PV-Lab/vcd/README.md

# vcd
A vacuum crystallization drying build within the ADDEPT collaboration
