PV-Lab/vcd/stp files/10cm VCD perforated sample stage.stp

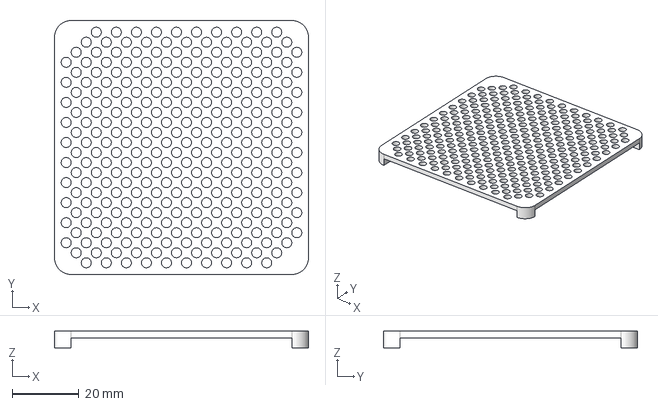
[picture p1: CAD file, 2026-03-06]
stp files/10cm VCD perforated sample stage.stp
76.0 x 76.0 x 5.00 mm
