PV-Lab/vcd/stp files/10cm VCD lid with window.stp

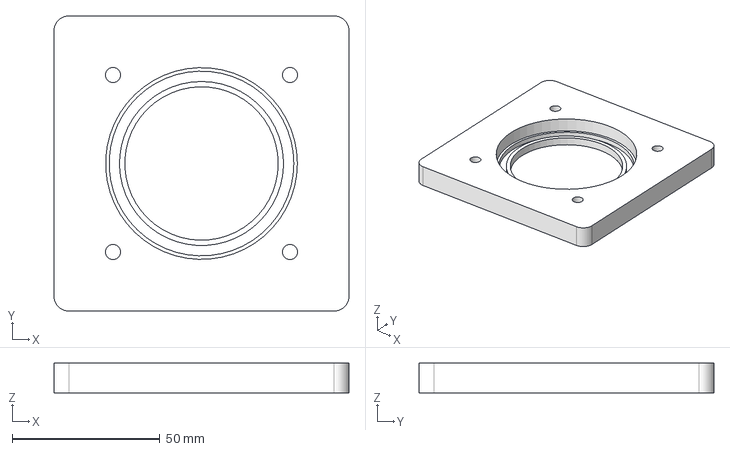
[picture p2: CAD file, 2026-03-06]
stp files/10cm VCD lid with window.stp
100.0 x 100.0 x 10.0 mm
