PV-Lab/vcd/stp files/10cm VCD GIWAXS sample stage.stp

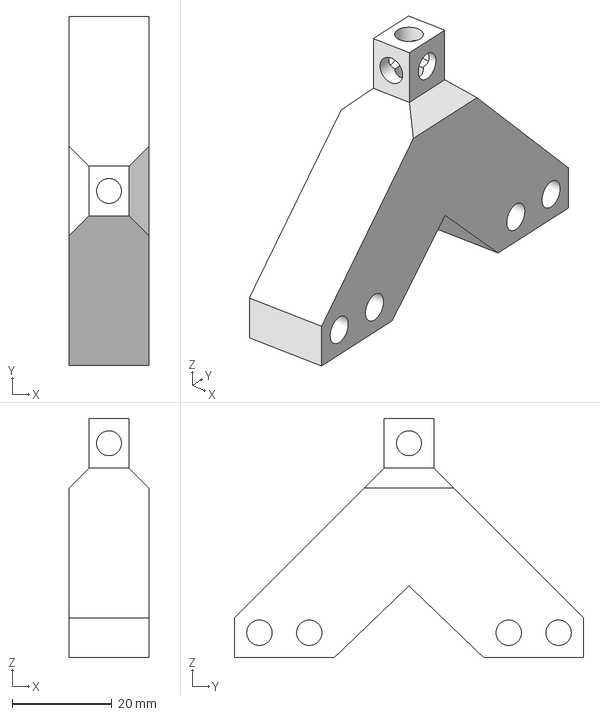
[picture p3: CAD file, 2026-03-06]
stp files/10cm VCD GIWAXS sample stage.stp
16.0 x 70.0 x 48.0 mm
