PV-Lab/vcd/stp files/10cm VCD GIWAXS lid.stp

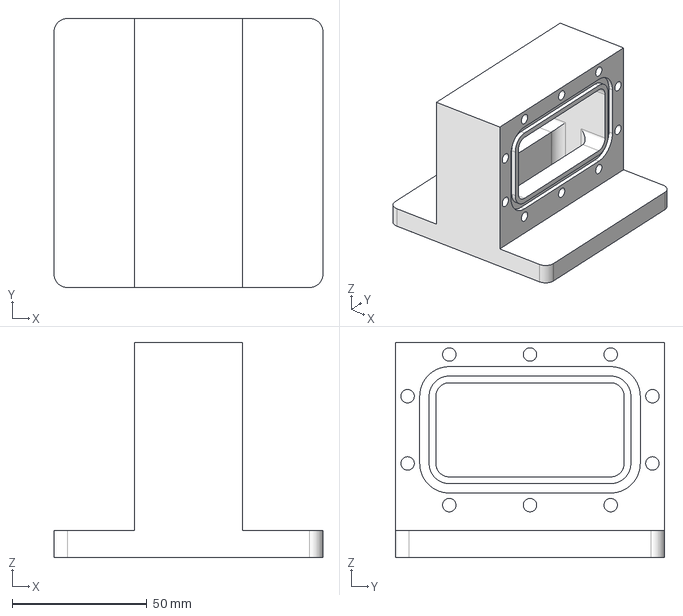
[picture p4: CAD file, 2026-03-06]
stp files/10cm VCD GIWAXS lid.stp
100.0 x 100.0 x 80.0 mm
