PV-Lab/vcd/stp files/10cm VCD base chamber.stp

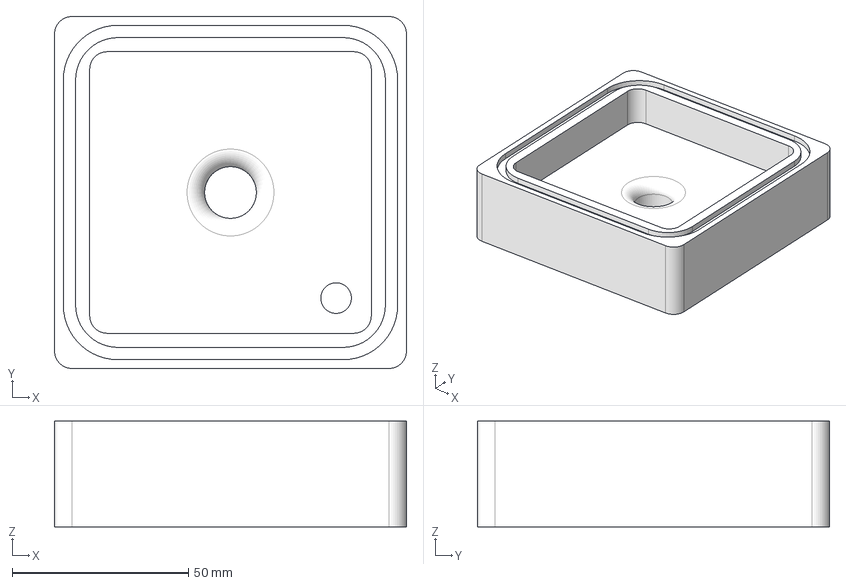
[picture p5: CAD file, 2026-03-06]
stp files/10cm VCD base chamber.stp
100.0 x 100.0 x 30.0 mm
