PV-Lab/vcd/stp files/10cm VCD GIWAXS window holders.stp

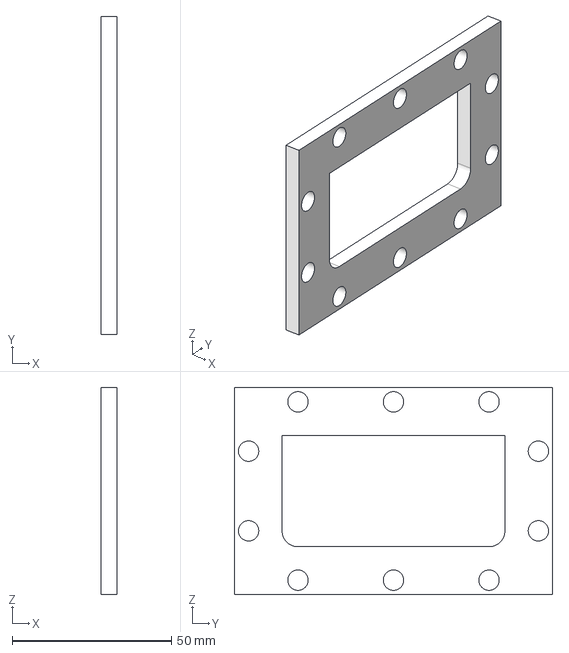
[picture p6: CAD file, 2026-03-06]
stp files/10cm VCD GIWAXS window holders.stp
5.00 x 100.0 x 65.0 mm
