PV-Lab/vcd/stp files/10cm VCD window mounting plate.stp

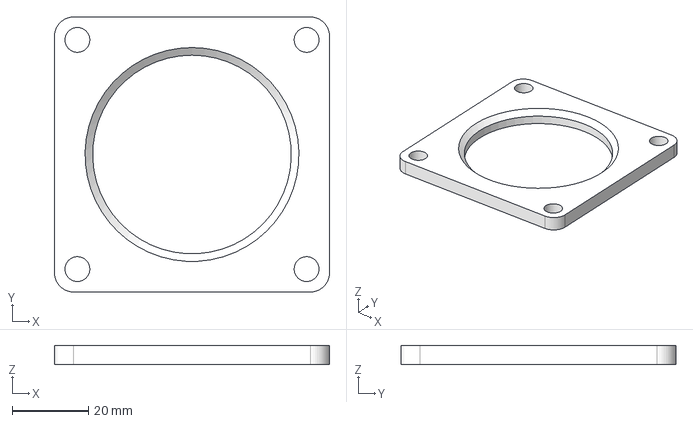
[picture p7: CAD file, 2026-03-06]
stp files/10cm VCD window mounting plate.stp
72.0 x 72.0 x 5.00 mm
