PV-Lab/vcd/stp files/10cm VCD base chamber side and bottom NPT.stp

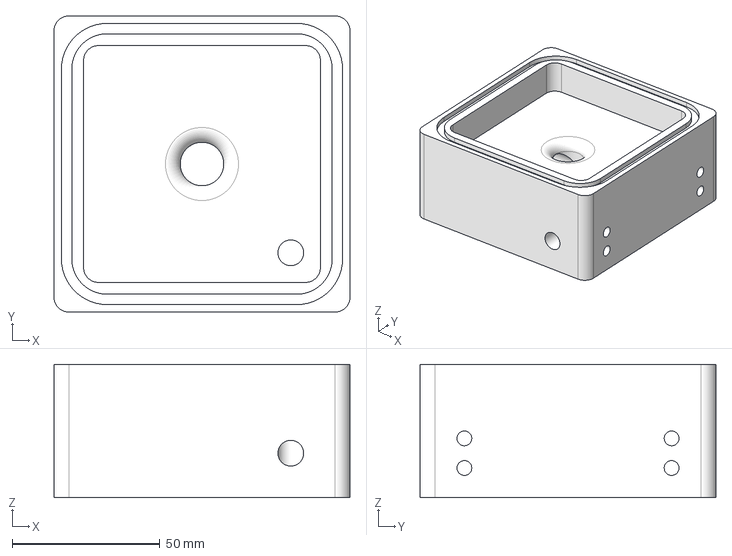
[picture p8: CAD file, 2026-03-06]
stp files/10cm VCD base chamber side and bottom NPT.stp
100.0 x 100.0 x 45.0 mm
