PV-Lab/vcd/solidworks/B-2MA4-SwagelokCompany-3D-07-16-2025.SLDPRT

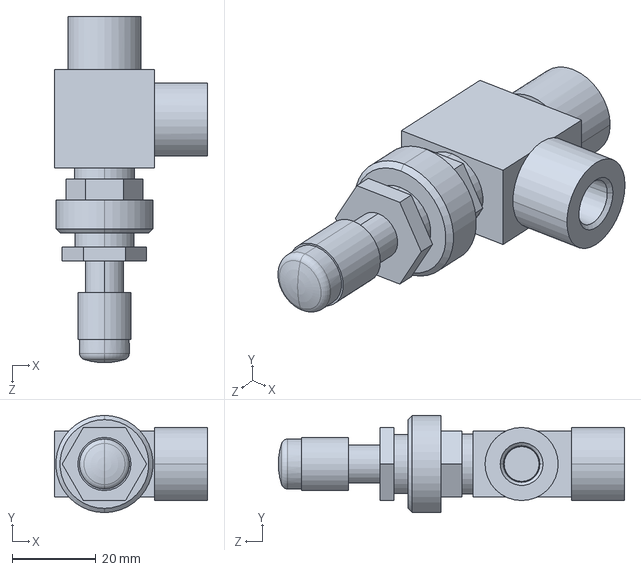
[picture p9: CAD file, 2026-04-05]
solidworks/B-2MA4-SwagelokCompany-3D-07-16-2025.SLDPRT
36.6 x 23.2 x 82.8 mm
