PV-Lab/vcd/solidworks/D1G1011200-A-APG200-XM-NW16-9-PIND.SLDPRT

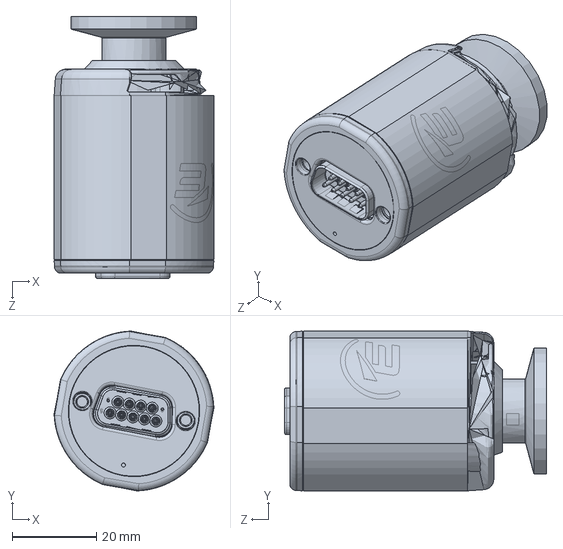
[picture p10: CAD file, 2026-04-05]
solidworks/D1G1011200-A-APG200-XM-NW16-9-PIND.SLDPRT
38.0 x 38.0 x 62.3 mm
