PV-Lab/vcd/solidworks/Window O-Ring.SLDPRT

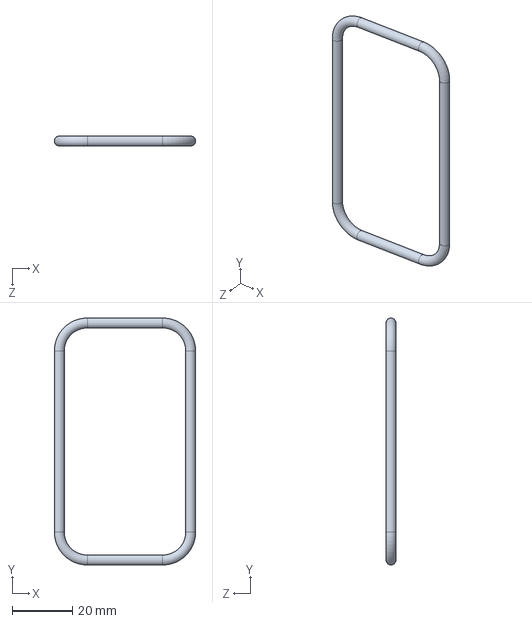
[picture p11: CAD file, 2026-04-05]
solidworks/Window O-Ring.SLDPRT
46.8 x 81.8 x 3.30 mm
