PV-Lab/vcd/solidworks/Lid O-Ring.SLDPRT

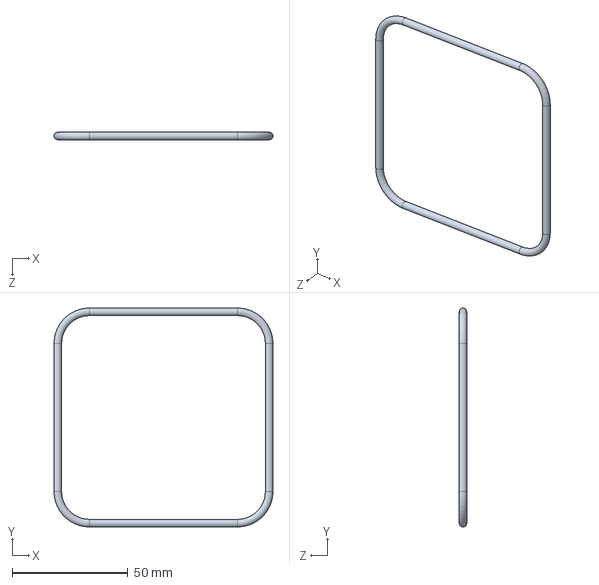
[picture p12: CAD file, 2026-04-05]
solidworks/Lid O-Ring.SLDPRT
94.8 x 94.8 x 3.30 mm
