PV-Lab/vcd/solidworks/Lid Window Film.SLDPRT

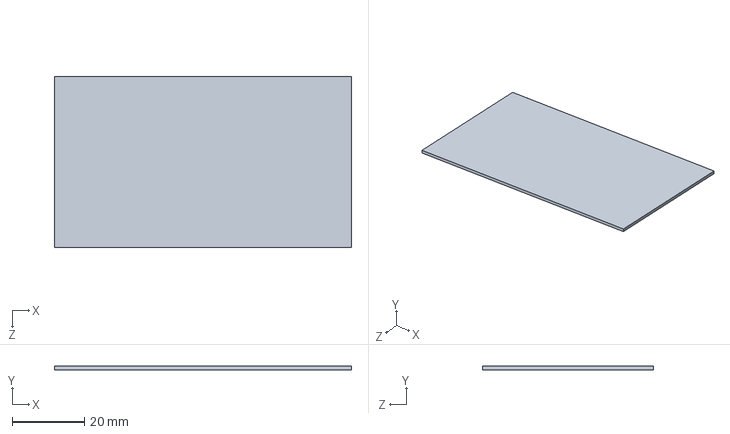
[picture p13: CAD file, 2026-04-05]
solidworks/Lid Window Film.SLDPRT
82.5 x 1.00 x 47.5 mm
