PV-Lab/vcd/solidworks/48805K72_Precision Extreme-Pressure 316 Stainless Steel Fitting.SLDPRT

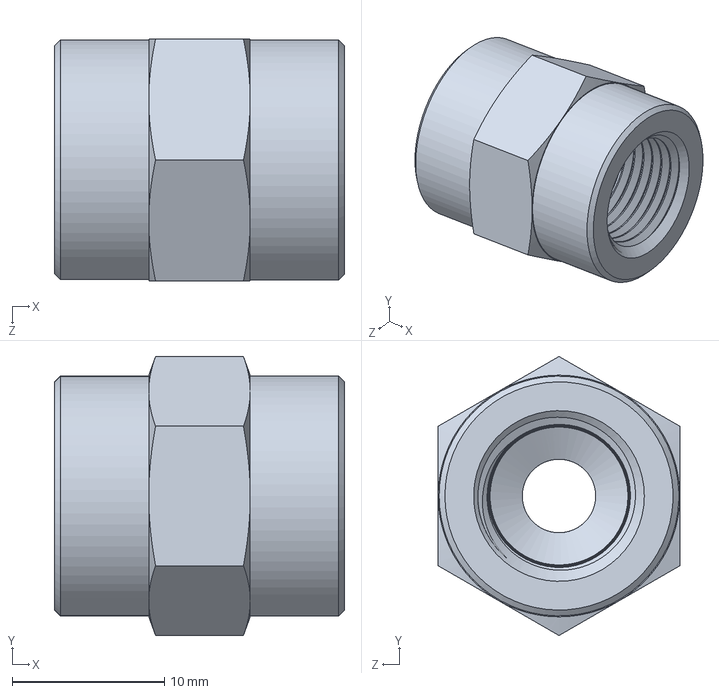
[picture p14: CAD file, 2026-04-05]
solidworks/48805K72_Precision Extreme-Pressure 316 Stainless Steel Fitting.SLDPRT
19.1 x 18.3 x 15.9 mm
