PV-Lab/vcd/solidworks/9263K521_Chemical-Resistant Viton Fluoroelastomer O-Ring.SLDPRT

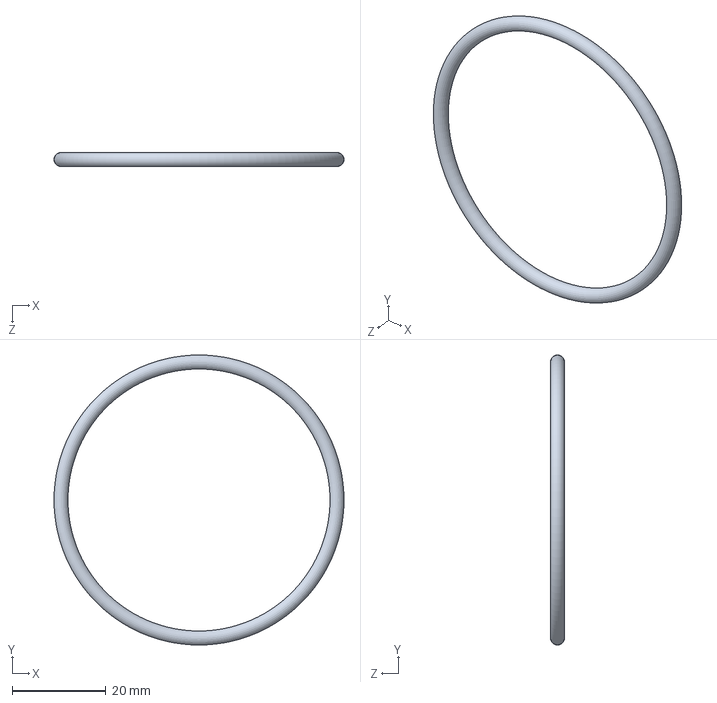
[picture p15: CAD file, 2026-04-05]
solidworks/9263K521_Chemical-Resistant Viton Fluoroelastomer O-Ring.SLDPRT
62.0 x 62.0 x 3.00 mm
