PV-Lab/vcd/solidworks/VCDwithwindow_exploded.SLDASM

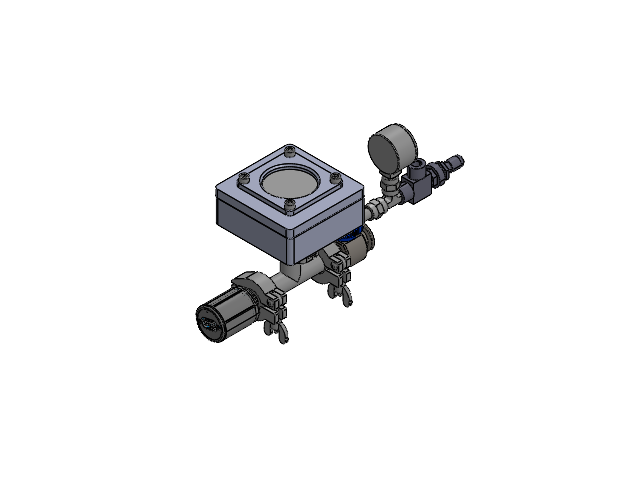
[picture p16: CAD file, 2026-04-05]
solidworks/VCDwithwindow_exploded.SLDASM
4518K191_Quick-Clamp High-Vacuum Fitting
4518K815_Ring with Screen for 3-4 Tube OD Quick-Clamp High-Vacuum Fitting
10cm VCD base chamber
Lid O-Ring
4518K621_Fluoroelastomer Rubber O-Ring for 3-4 Tube OD Quick-Clamp High-Vacuum Fitting x 2
48805K18_Precision Extreme-Pressure 316 Stainless Steel Fitting
4002K15_Vacuum Gauge with Steel Case
44615K421_Standard-Wall Steel Pipe Nipple
48805K124_Precision Extreme-Pressure 316 Stainless Steel Fitting
48805K72_Precision Extreme-Pressure 316 Stainless Steel Fitting x 2
B-2MA4-SwagelokCompany-3D-07-16-2025
4518K711_Quick-Clamp High-Vacuum Fitting x 3
P104242
10cm VCD lid with window
10cm VCD perforated sample stage
10cm VCD window mounting plate
1357T55_Ultra-High-Temperature Quartz Glass
9263K521_Chemical-Resistant Viton Fluoroelastomer O-Ring x 2
D1G1011200-A-APG200-XM-NW16-9-PIND
92290A316_Super-Corrosion-Resistant 316 Stainless Steel Socket Head Screw x 4
P108308
