PV-Lab/vcd/solidworks/VCDgiwaxs_exploded.SLDASM

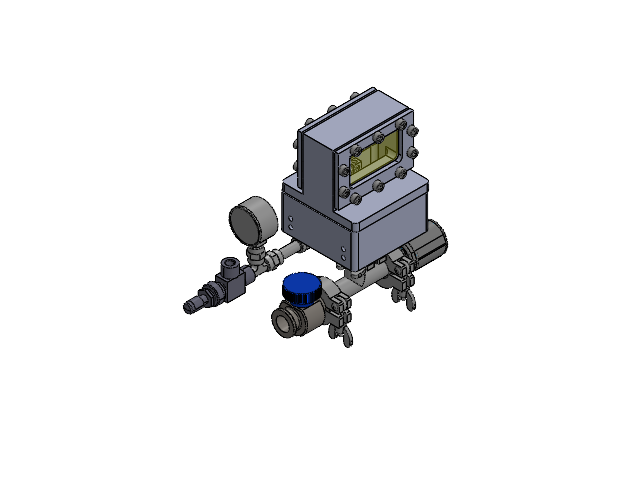
[picture p17: CAD file, 2026-04-05]
solidworks/VCDgiwaxs_exploded.SLDASM
4518K191_Quick-Clamp High-Vacuum Fitting
4518K815_Ring with Screen for 3-4 Tube OD Quick-Clamp High-Vacuum Fitting
Lid O-Ring
4518K621_Fluoroelastomer Rubber O-Ring for 3-4 Tube OD Quick-Clamp High-Vacuum Fitting x 2
48805K18_Precision Extreme-Pressure 316 Stainless Steel Fitting
4002K15_Vacuum Gauge with Steel Case
44615K421_Standard-Wall Steel Pipe Nipple
48805K124_Precision Extreme-Pressure 316 Stainless Steel Fitting
48805K72_Precision Extreme-Pressure 316 Stainless Steel Fitting x 2
B-2MA4-SwagelokCompany-3D-07-16-2025
4518K711_Quick-Clamp High-Vacuum Fitting x 3
P104242
D1G1011200-A-APG200-XM-NW16-9-PIND
10cm VCD base chamber side and bottom NPT
10cm VCD GIWAXS lid
10cm VCD GIWAXS sample stage
10cm VCD GIWAXS window holders x 2
91290A207_Black-Oxide Alloy Steel Socket Head Screw x 4
Window O-Ring x 2
Lid Window Film x 2
50925K389_Compact Extreme-Pressure Steel Pipe Fitting
50925K392_Compact Extreme-Pressure Steel Pipe Fitting
92290A316_Super-Corrosion-Resistant 316 Stainless Steel Socket Head Screw x 20
P108308
