PV-Lab/vcd/(list of files, cad)

Other CAD files:
solidworks/10cm VCD GIWAXS lid.SLDPRT
solidworks/10cm VCD GIWAXS sample stage.SLDPRT
solidworks/10cm VCD GIWAXS window holders.SLDPRT
solidworks/10cm VCD base chamber side and bottom NPT.SLDPRT
solidworks/10cm VCD base chamber.SLDPRT
solidworks/10cm VCD lid no window.SLDPRT
solidworks/10cm VCD lid with window.SLDPRT
solidworks/10cm VCD perforated sample stage.SLDPRT
solidworks/10cm VCD window mounting plate.SLDPRT
solidworks/1357T55_Ultra-High-Temperature Quartz Glass.SLDPRT
solidworks/4002K15_Vacuum Gauge with Steel Case.SLDPRT
solidworks/44615K421_Standard-Wall Steel Pipe Nipple.SLDPRT
solidworks/4518K191_Quick-Clamp High-Vacuum Fitting.SLDPRT
solidworks/4518K621_Fluoroelastomer Rubber O-Ring for 3-4 Tube OD Quick-Clamp High-Vacuum Fitting.SLDPRT
solidworks/4518K711_Quick-Clamp High-Vacuum Fitting.SLDPRT
solidworks/4518K815_Ring with Screen for 3-4 Tube OD Quick-Clamp High-Vacuum Fitting.SLDPRT
solidworks/48805K124_Precision Extreme-Pressure 316 Stainless Steel Fitting.SLDPRT
solidworks/48805K18_Precision Extreme-Pressure 316 Stainless Steel Fitting.SLDPRT
solidworks/50925K389_Compact Extreme-Pressure Steel Pipe Fitting.SLDPRT
solidworks/50925K392_Compact Extreme-Pressure Steel Pipe Fitting.SLDPRT
solidworks/7784N47_Ultra-High-Temperature Quartz Glass Sheet.SLDPRT
solidworks/91290A207_Black-Oxide Alloy Steel Socket Head Screw.SLDPRT
solidworks/92290A316_Super-Corrosion-Resistant 316 Stainless Steel Socket Head Screw.SLDPRT
solidworks/P101217.sldprt
solidworks/P104242.sldprt
solidworks/P108308.sldprt
