PV-Lab/vcd/Dimensioned Drawings/10cm VCD lid with window.pdf

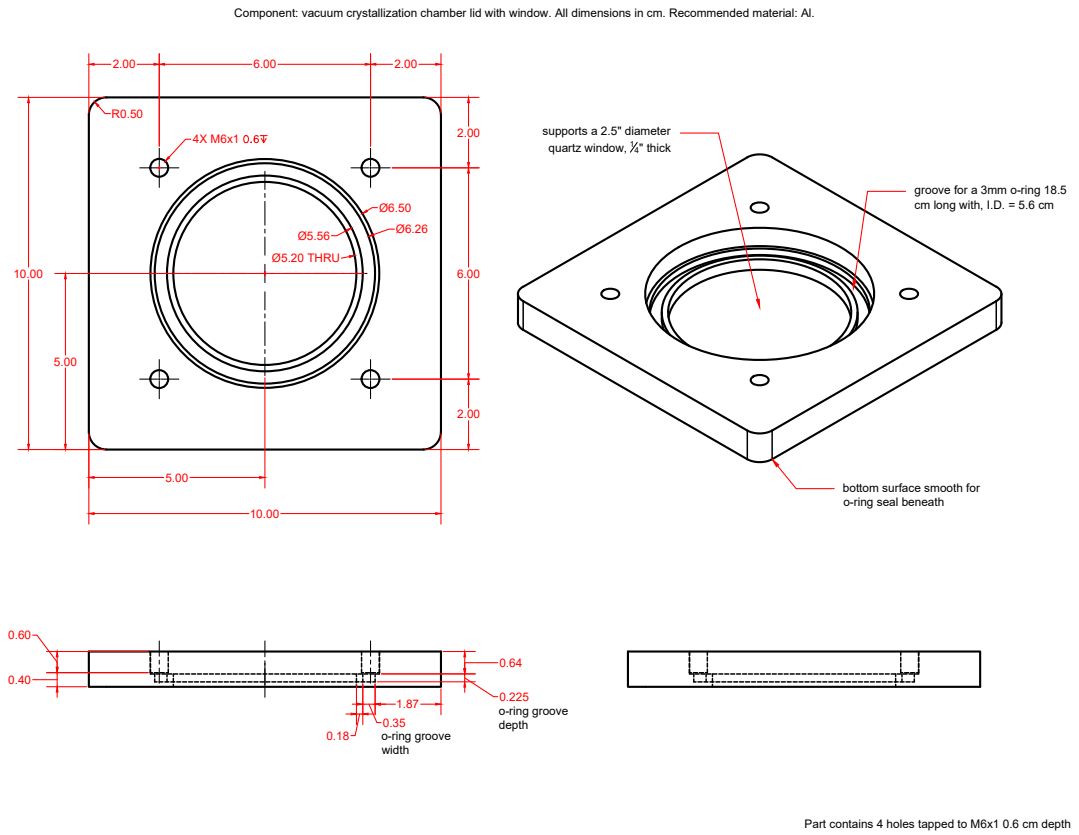
[picture p18: page 1]
Component: vacuum crystallization chamber lid with window. All dimensions in cm. Recommended material: Al. 10.00; 2.00 6.00 2.00 Ø5.20 THRU Ø5.56; 0.64 0.225 o-ring groove depth 0.40; o-ring groove width R0.50; bottom surface smooth for o-ring seal beneath groove for a 3mm o-ring 18.5 cm long with, I.D. = 5.6 cm supports a 2.5" diameter quartz window, 1; 4" thick; Part contains 4 holes tapped to M6x1 0.6 cm depth
