PV-Lab/vcd/Dimensioned Drawings/10cm VCD window mounting plate.pdf

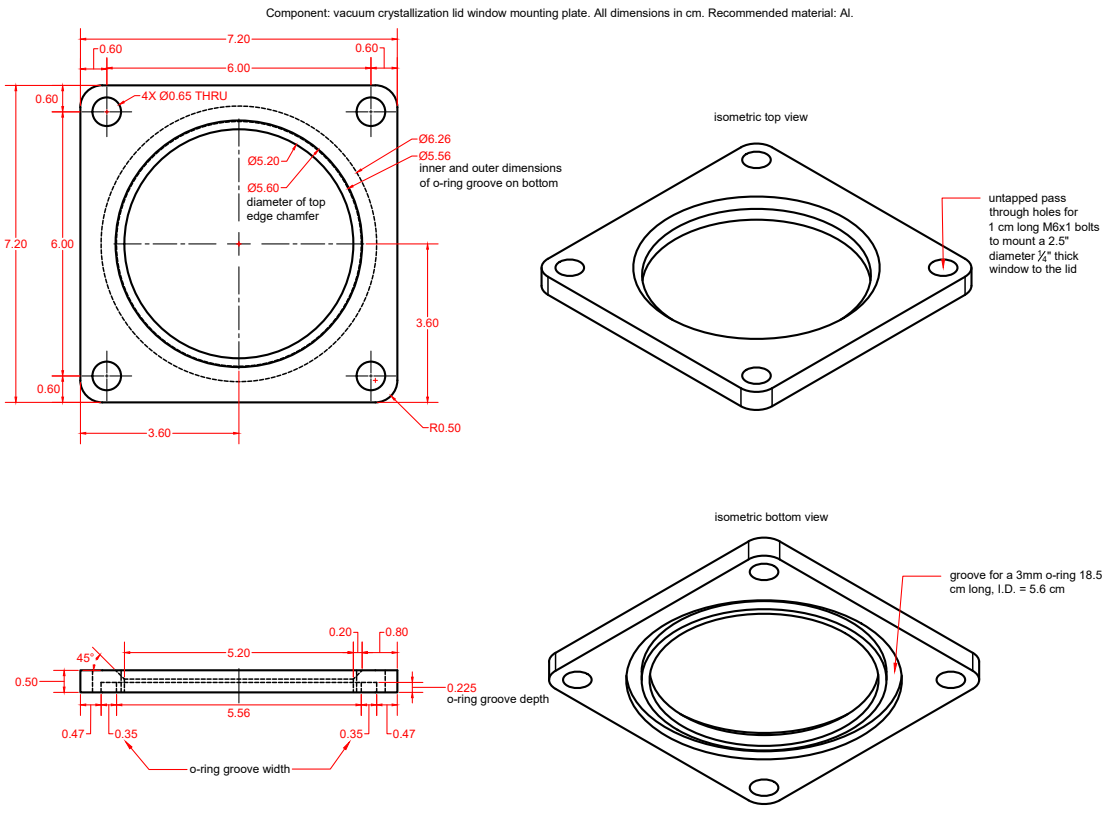
[picture p19: page 1]
Component: vacuum crystallization lid window mounting plate. All dimensions in cm. Recommended material: Al. isometric top view isometric bottom view 4X Ø0.65 THRU 7.20; Ø6.26 Ø5.56 inner and outer dimensions of o-ring groove on bottom Ø5.20 Ø5.60 3.60; untapped pass through holes for 1 cm long M6x1 bolts to mount a 2.5" diameter 1; 4" thick window to the lid groove for a 3mm o-ring 18.5 cm long, I.D. = 5.6 cm 0.47; 0.225 o-ring groove depth o-ring groove width 0.50; diameter of top edge chamfer
