PV-Lab/vcd/Dimensioned Drawings/10cm VCD base chamber side and bottom NPT connections.pdf

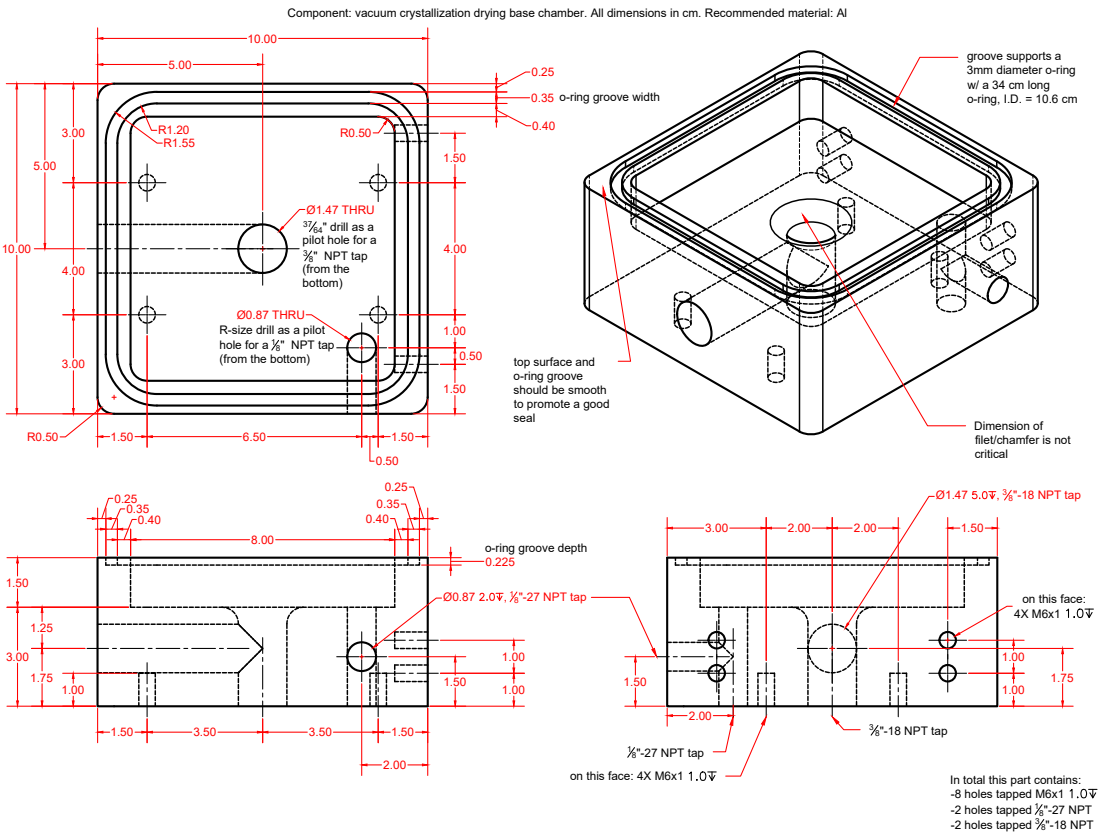
[picture p20: page 1]
Component: vacuum crystallization drying base chamber. All dimensions in cm. Recommended material: Al 10.00 5.00; Ø1.47 THRU 3.00; 8"-27 NPT tap; 8"-18 NPT tap; Dimension of filet/chamfer is not critical 0.40 0.35 0.25 o-ring groove width o-ring groove depth R0.50; top surface and o-ring groove should be smooth to promote a good seal; groove supports a 3mm diameter o-ring w/ a 34 cm long o-ring, I.D. = 10.6 cm 1.75 3.00 4.00 3.00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

8" NPT tap (from the bottom)37 64" drill as a pilot hole for a

8"-27 NPT -2 holes tapped 3
