PV-Lab/vcd/Dimensioned Drawings/10cm VCD base chamber.pdf

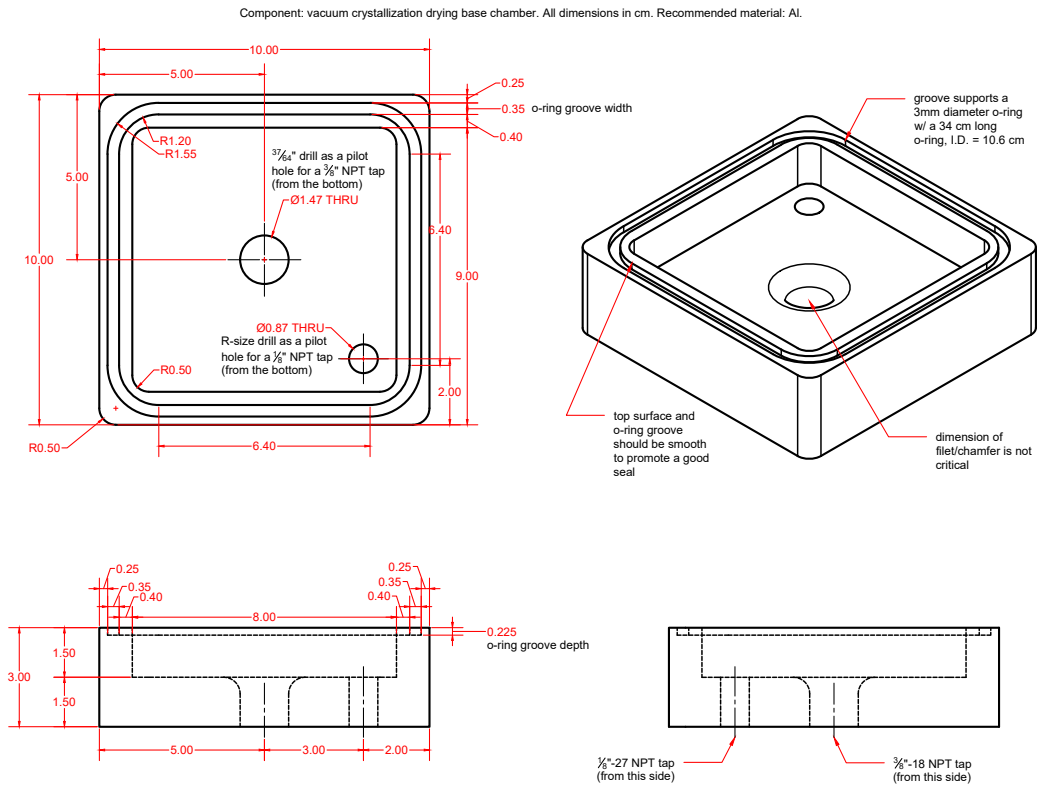
[picture p21: page 1]
Component: vacuum crystallization drying base chamber. All dimensions in cm. Recommended material: Al. 10.00 5.00; Ø1.47 THRU; 2.00 R-size drill as a pilot hole for a 1; 8" NPT tap (from the bottom) 5.00; 8"-27 NPT tap (from this side); 8"-18 NPT tap (from this side) dimension of filet/chamfer is not critical 0.40 0.35 0.25 o-ring groove width o-ring groove depth R0.50; top surface and o-ring groove should be smooth to promote a good seal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
