PV-Lab/vcd/Dimensioned Drawings/10cm VCD GIWAXS lid.pdf

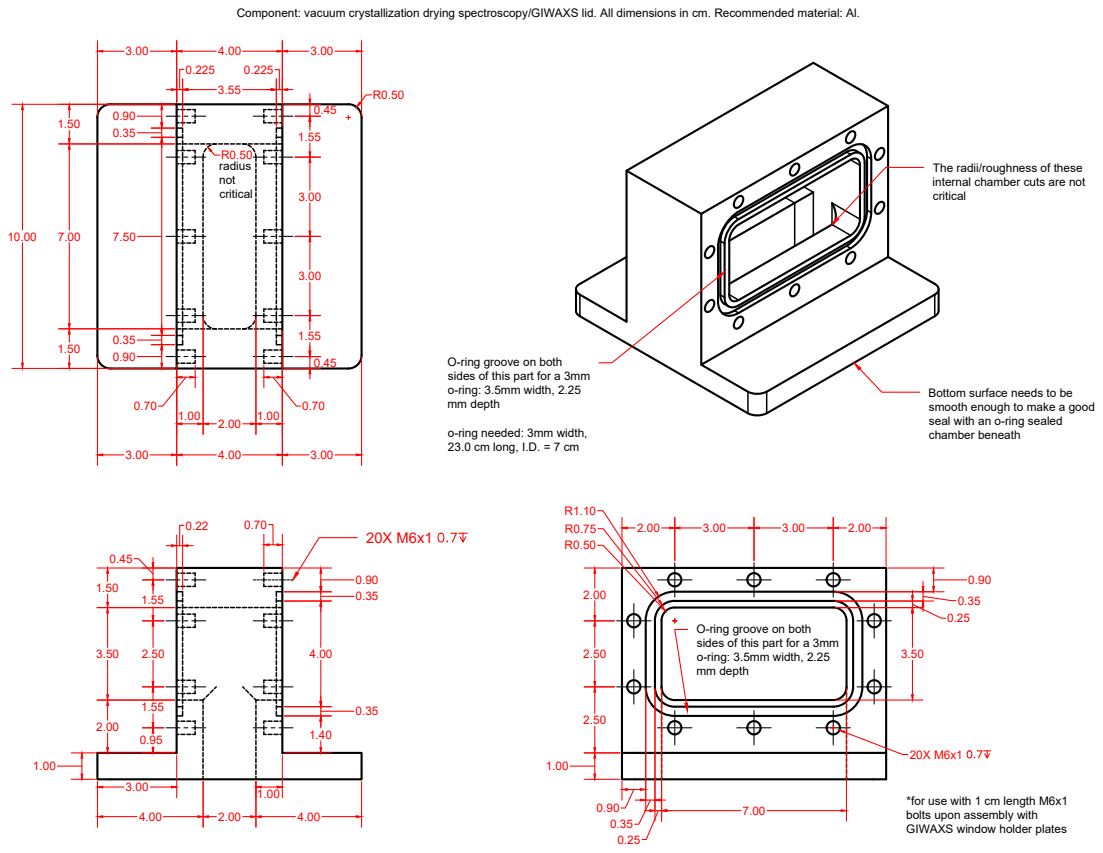
[picture p22: page 1]
0.70 radius not critical 1.00; 0.250.350.90 20X M6x1 *for use with 1 cm length M6x1 bolts upon assembly with GIWAXS window holder plates O-ring groove on both sides of this part for a 3mm o-ring: 3.5mm width, 2.25 mm depth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
