PV-Lab/vcd/Dimensioned Drawings/10cm VCD GIWAXS sample stage.pdf

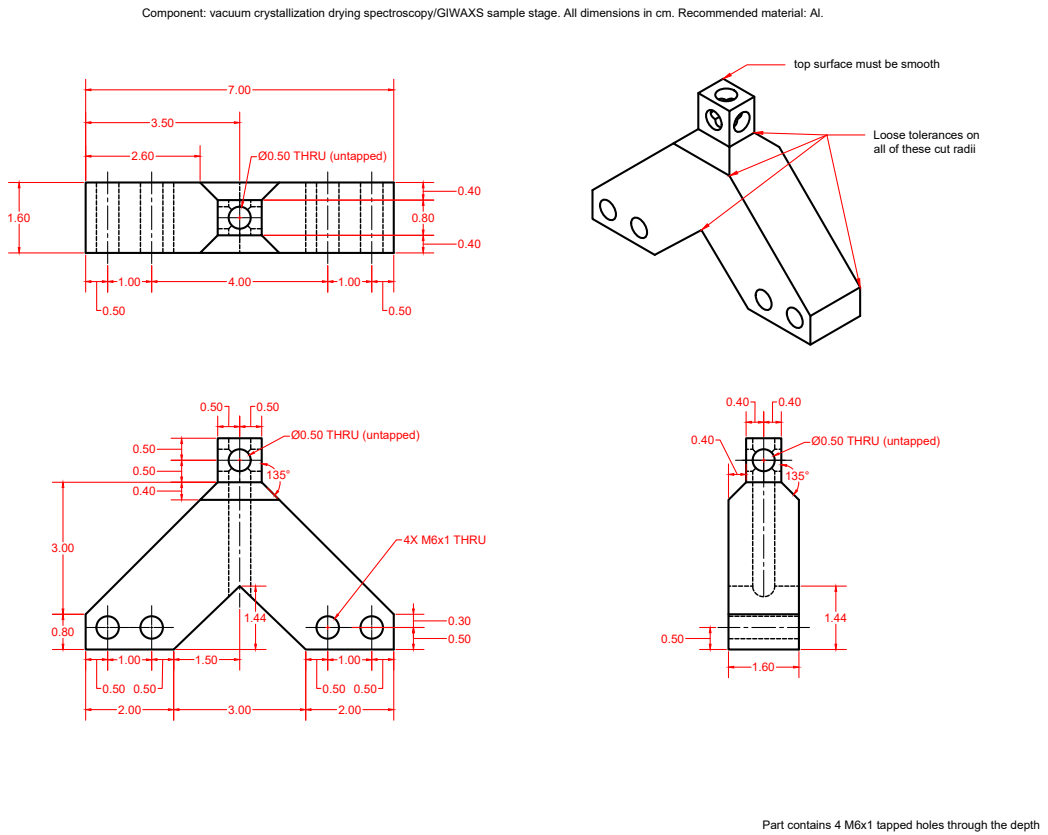
[picture p23: page 1]
Component: vacuum crystallization drying spectroscopy/GIWAXS sample stage. All dimensions in cm. Recommended material: Al. 1.60; 0.50 Ø0.50 THRU (untapped) 135° 0.501.000.50; 0.50 0.30 4X M6x1 THRU; 0.40 Ø0.50 THRU (untapped) 1.44 0.40 Ø0.50 THRU (untapped); Part contains 4 M6x1 tapped holes through the depth Loose tolerances on all of these cut radii top surface must be smooth
