PV-Lab/vcd/Dimensioned Drawings/10cm VCD GIWAXS window holders.pdf

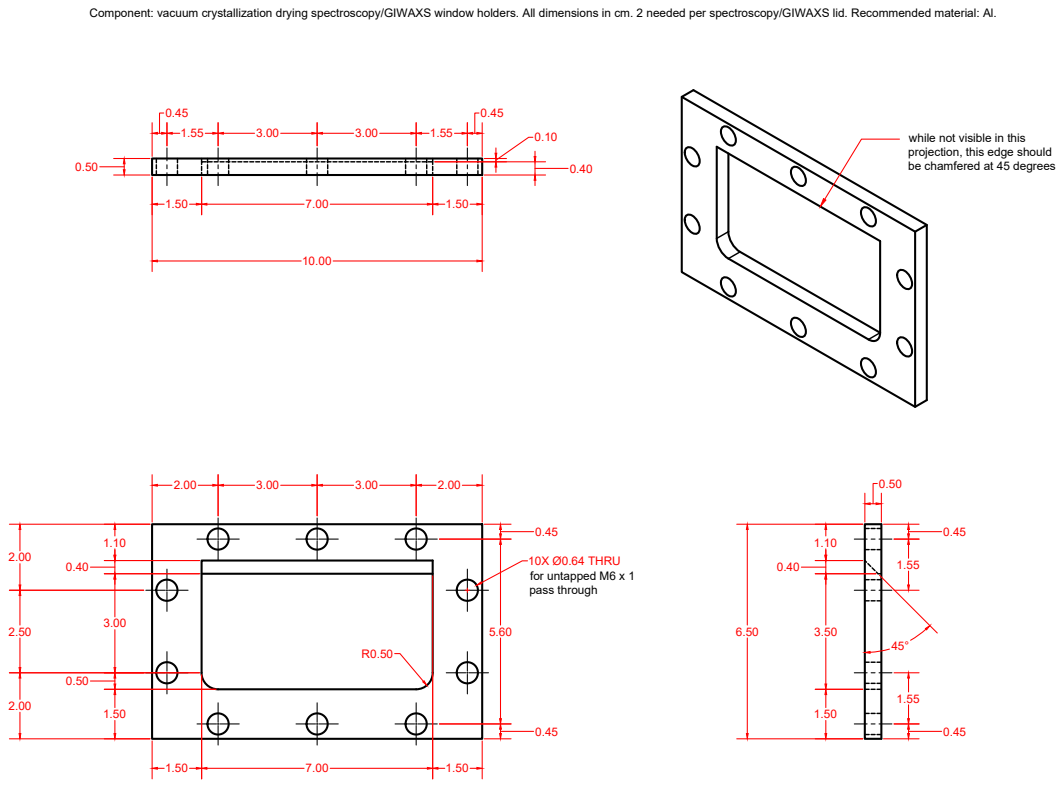
[picture p24: page 1]
Component: vacuum crystallization drying spectroscopy/GIWAXS window holders. All dimensions in cm. 2 needed per spectroscopy/GIWAXS lid. Recommended material: Al. 45° 2.00 2.50 2.00; 0.45 10X Ø0.64 THRU R0.50 2.00; while not visible in this projection, this edge should be chamfered at 45 degrees for untapped M6 x 1 pass through
