PV-Lab/vcd/Dimensioned Drawings/10cm VCD lid without window.pdf

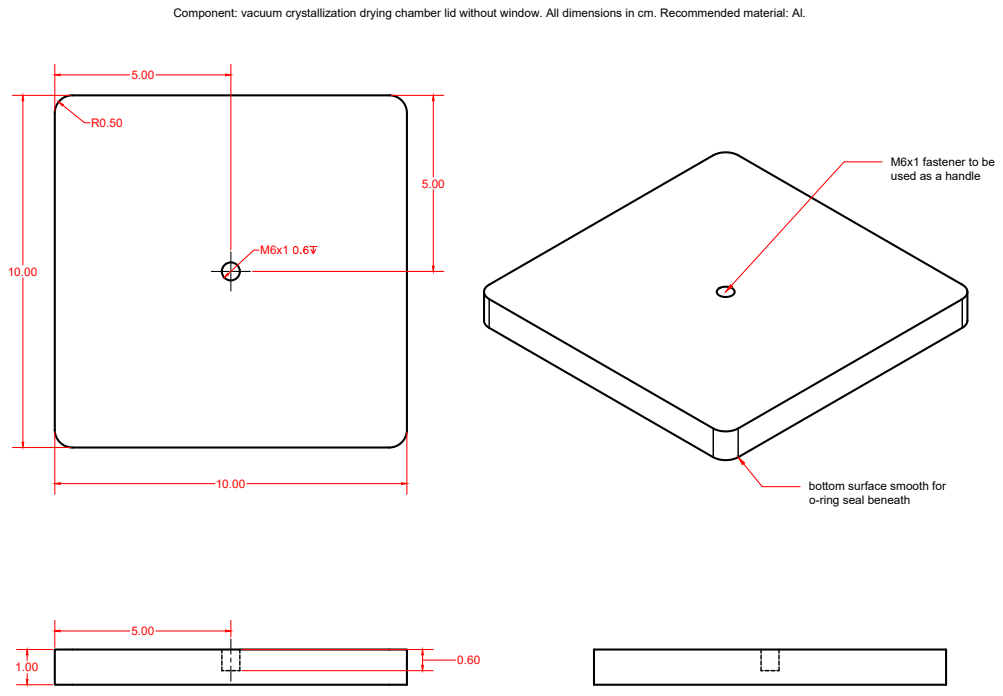
[picture p25: page 1]
Component: vacuum crystallization drying chamber lid without window. All dimensions in cm. Recommended material: Al. bottom surface smooth for o-ring seal beneath 10.00; M6x1 fastener to be used as a handle
