PV-Lab/vcd/Dimensioned Drawings/10cm VCD perforated sample stage.pdf

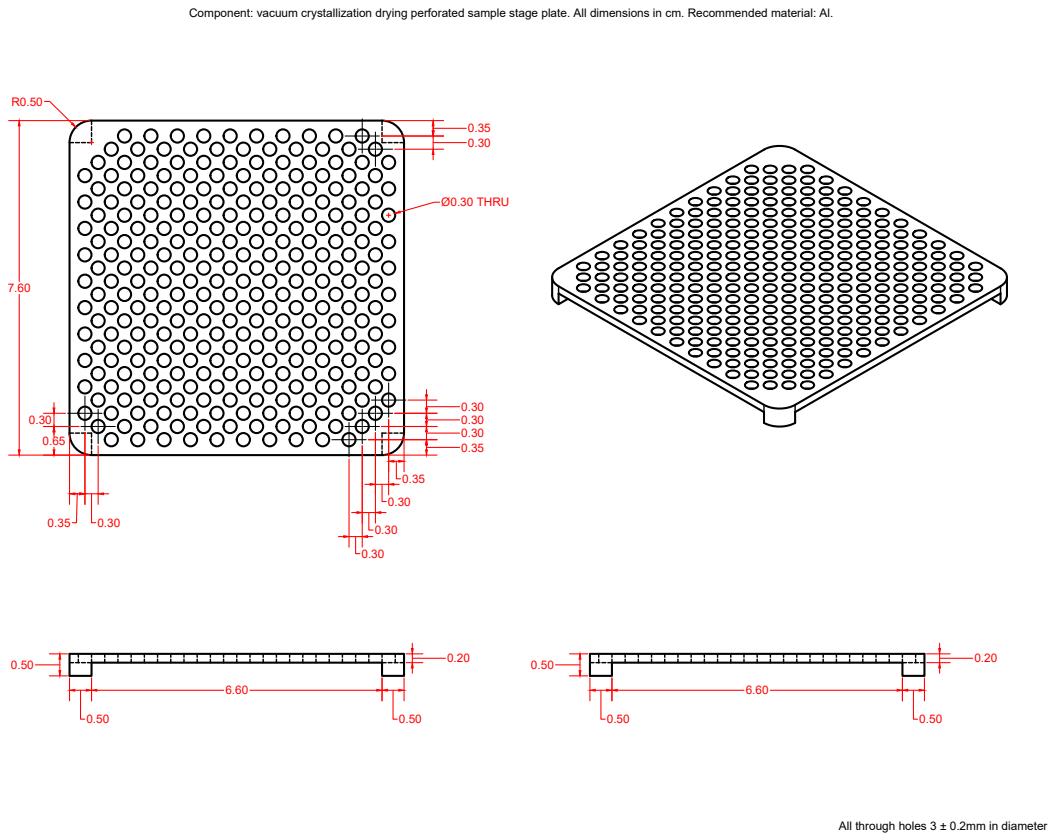
[picture p26: page 1]
Component: vacuum crystallization drying perforated sample stage plate. All dimensions in cm. Recommended material: Al. 7.60 0.50; Ø0.30 THRU; All through holes 3 ± 0.2mm in diameter
